mmilleror/HT-15/(commit log)

2025-10-15 removed extra component unconnected in schematic
2025-10-20 removed epaper library because it only supports 4wire and wrote encoder state code
2025-10-20 encoder debounce
2025-10-21 implemented volume knob code
    [OSS Radio Hardware Design.kicad_pcb]
2025-11-05 all RF mmatching should be done on the 2M70CM board
    [OSS-Radio_2M70CM.kicad_sch]
2025-11-05 added test points
    [OSS-Radio_2M70CM.kicad_sch]
2025-11-07 working on RF module layout
    [OSS-Radio_2M70CM.kicad_pcb, OSS-Radio_2M70CM.kicad_sch]
2025-11-08 arranged components on RF PCB
    [OSS-Radio_2M70CM.kicad_pcb, OSS-Radio_2M70CM.kicad_sch]
2025-11-11 layout of RF board
    [OSS-Radio_2M70CM.kicad_pcb, OSS-Radio_2M70CM.kicad_sch]
2025-11-12 fixed RF board DRC errors
    [OSS-Radio_2M70CM.kicad_pcb]
2025-11-12 small rf board changes
    [OSS-Radio_2M70CM.kicad_pcb]
2025-11-12 working on BOM
    [OSS-Radio_2M70CM.kicad_pcb, OSS-Radio_2M70CM.kicad_sch]
2025-11-14 Made BOM and modified footprints and thus layout
    [OSS-Radio_2M70CM.kicad_pcb, OSS-Radio_2M70CM.kicad_sch]
2025-11-24 removed problematic ground via on RF board
    [OSS-Radio_2M70CM.kicad_pcb]
2025-11-25 changed RF board stnadoff height to 1.5mm
    [OSS-Radio_2M70CM.kicad_pcb, OSS-Radio_2M70CM.kicad_sch]
2025-11-27 pre-release for 2M70CM board 0.1
    [OSS-Radio_2M70CM-B_Cu.gbr, OSS-Radio_2M70CM-B_Mask.gbr, OSS-Radio_2M70CM-B_Paste.gbr, OSS-Radio_2M70CM-B_Silkscreen.gbr, OSS-Radio_2M70CM-Edge_Cuts.gbr, OSS-Radio_2M70CM-F_Cu.gbr, OSS-Radio_2M70CM-F_Mask.gbr, OSS-Radio_2M70CM-F_Paste.gbr]
